Sol455/mic_patch_v1/README.md

#Prototype Wearable Microphone patch for cardiac auscultation

#Parts and Footprint Libraries

Parts located in mic_patch_parts.kicad_sym
Footprints located in parts >  mic_patch_parts.pretty
3D models located in parts  > mic_patch_models.3dspahes
