Sol455/mic_patch_v1/MCU.kicad_sch

## KiCad design MCU.kicad_sch (2025-06-24)

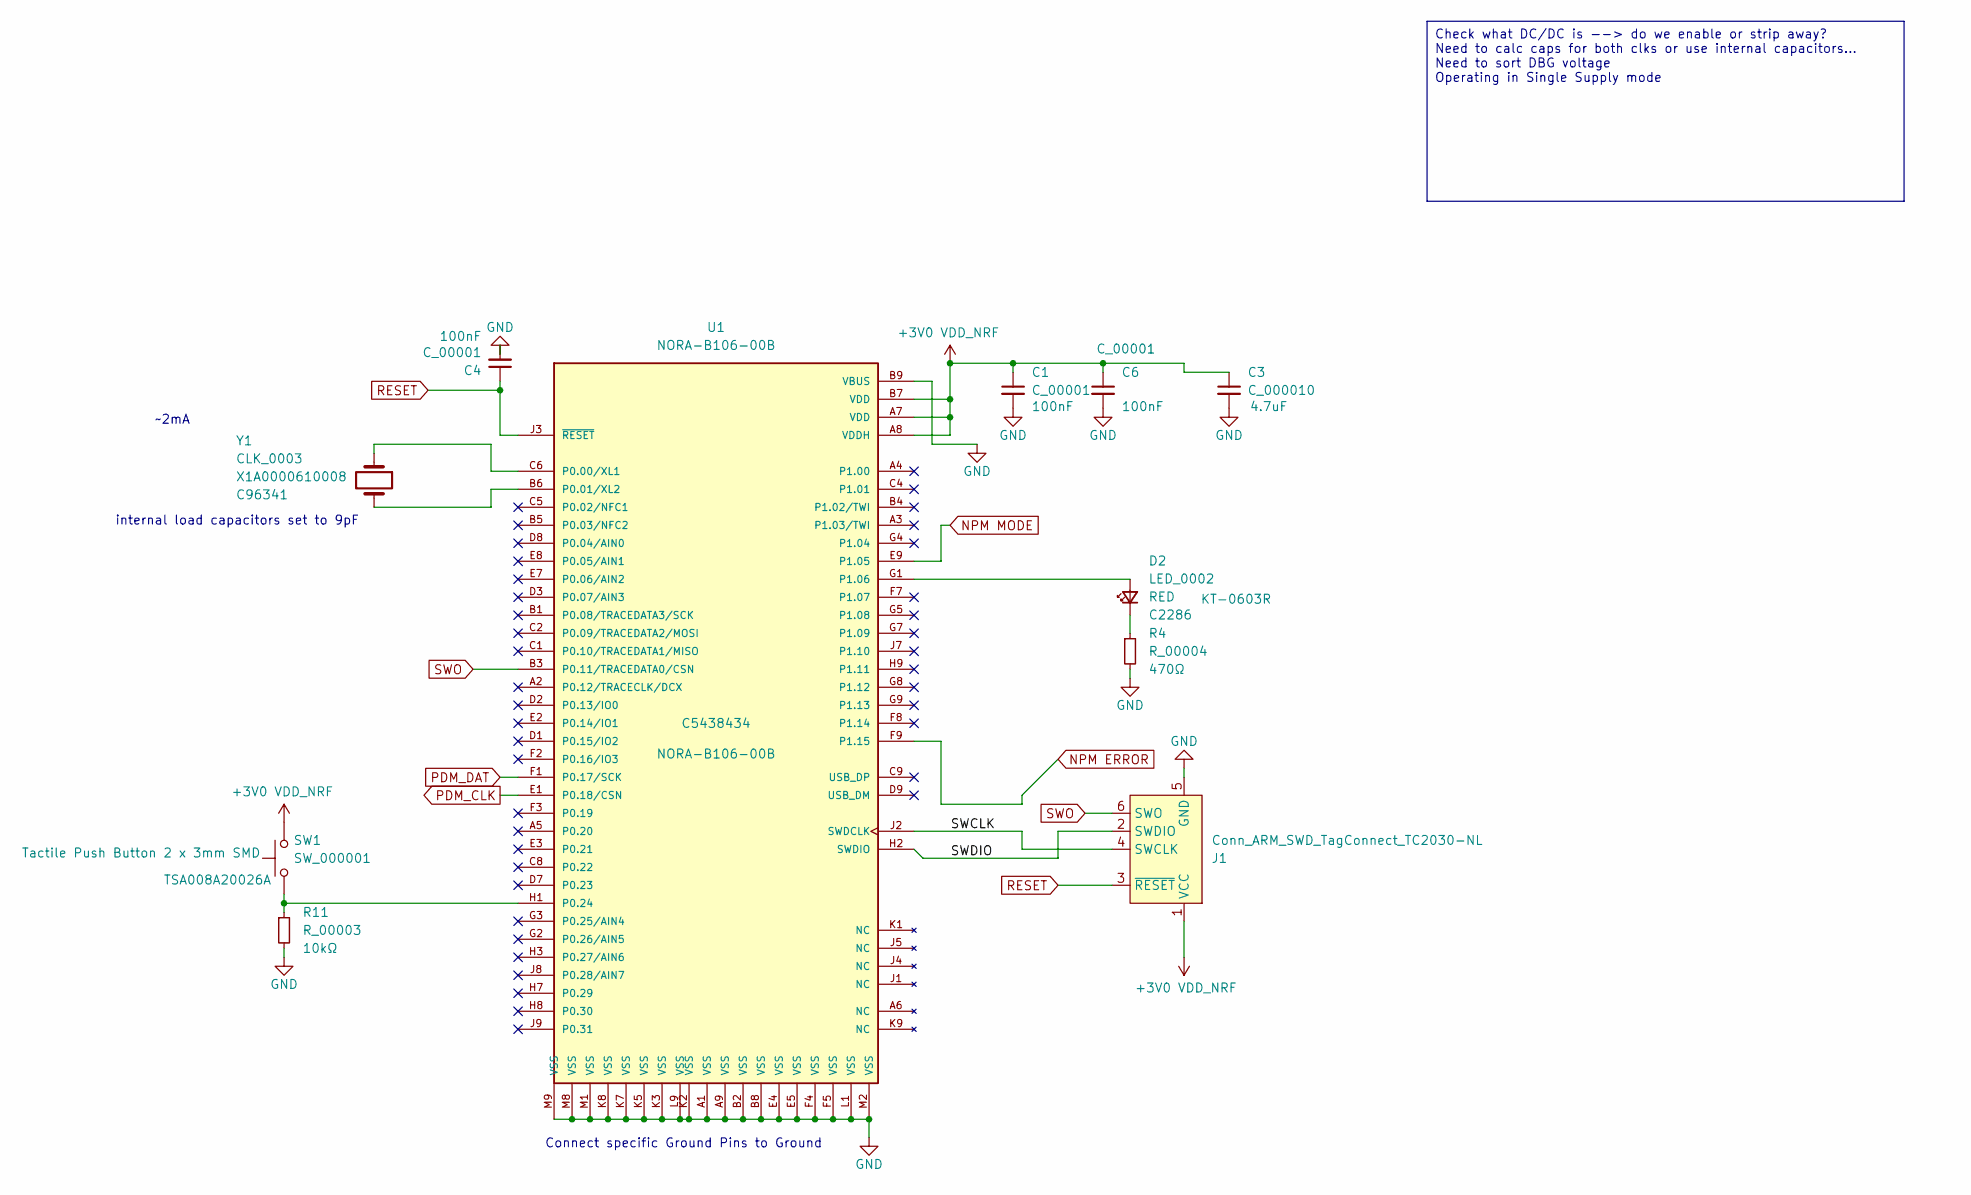
[picture p1: schematic MCU.kicad_sch]

Parts:
C1, C4, C6: C_00001; C_0402_1005Metric; MPNs 0402WGF1002TCE; LCSC PNs C25744
C3: C_000010; C_0402_1005Metric; MPNs CL05A475MP5NRNC; LCSC PNs C23733
D2: LED_0002; LED_0603_1608Metric; LCSC PNs C2286
J1: Conn_ARM_SWD_TagConnect_TC2030-NL; Tag-Connect_TC2030-IDC-NL_2x03_P1.27mm_Vertical
R4: R_00004; R_0402_1005Metric; MPNs 0402WGF4700TCE; LCSC PNs C25117
R11: R_00003; R_0402_1005Metric; MPNs 0402WGF1002TCE; LCSC PNs C25744
SW1: SW_000001; MPNs TSA008A20026A; LCSC PNs C2888880
U1: NORA-B106-00B; PARTREV R05; LCSC PNs C5438434
Y1: CLK_0003; Crystal_SMD_2012-2Pin_2.0x1.2mm; LCSC PNs C96341

Connections:
+3V0 VDD_NRF: C1.1, C3.1, C6.1, J1.1 (VCC), SW1.2, U1.A7 (VDD), U1.A8 (VDDH), U1.B7 (VDD)
GND: C1.2, C3.2, C4.2, C6.2, J1.5 (GND), R4.2, R11.2, U1.A1 (VSS), U1.A9 (VSS), U1.B2 (VSS), U1.B8 (VSS), U1.B9 (VBUS), U1.E4 (VSS), U1.E5 (VSS), U1.F4 (VSS), U1.F5 (VSS), U1.K2 (VSS), U1.K3 (VSS), U1.K5 (VSS), U1.K7 (VSS), U1.K8 (VSS), U1.L1 (VSS), U1.L9 (VSS), U1.M1 (VSS), U1.M2 (VSS), U1.M8 (VSS), U1.M9 (VSS)
NPM ERROR: U1.F9 (P1.15)
NPM MODE: U1.E9 (P1.05)
unnamed: D2.1 (K), R4.1
unnamed: D2.2 (A), U1.G1 (P1.06)
unnamed: R11.1, SW1.1, U1.H1 (P0.24)
unnamed: U1.B6 (P0.01/XL2), Y1.2
unnamed: U1.C6 (P0.00/XL1), Y1.1
PDM_CLK: U1.E1 (P0.18/CSN)
PDM_DAT: U1.F1 (P0.17/SCK)
RESET: C4.1, J1.3 (~RESET), U1.J3 (~RESET)
SWCLK: J1.4 (SWCLK), U1.J2 (SWDCLK)
SWDIO: J1.2 (SWDIO), U1.H2 (SWDIO)
SWO: J1.6 (SWO), U1.B3 (P0.11/TRACEDATA0/CSN)

Notes on the sheet:
Check what DC/DC is --> do we enable or strip away? Need to calc caps for both clks or use internal capacitors... Need to sort DBG voltage Operating in Single Supply mode
internal load capacitors set to 9pF
~2mA
Connect specific Ground Pins to Ground
