Sol455/mic_patch_v1/mic.kicad_sch

## KiCad design mic.kicad_sch (2025-06-24)

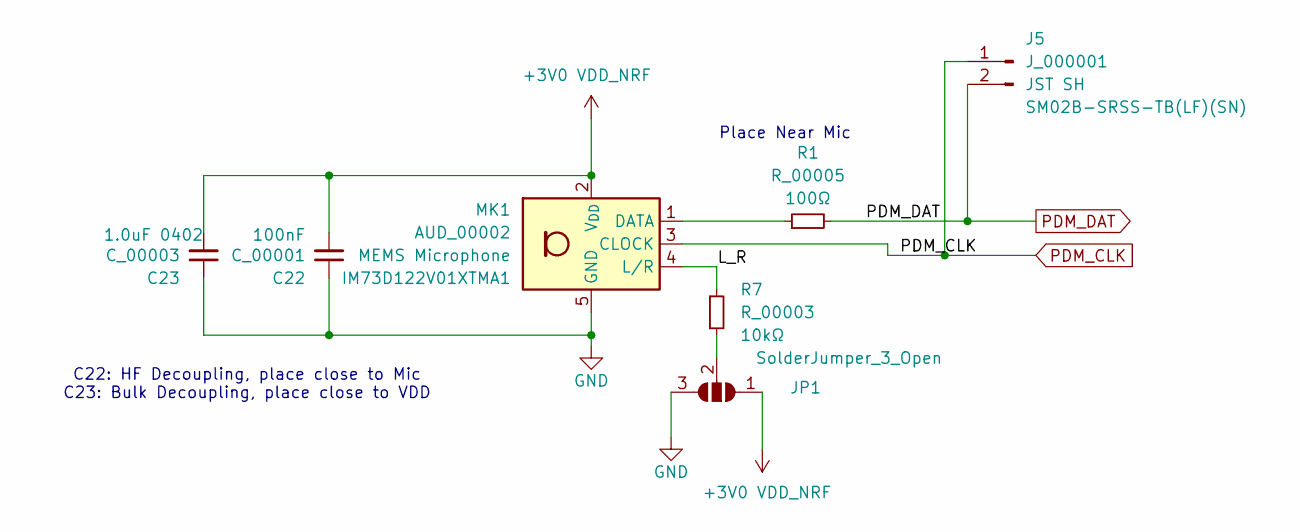
[picture p2: schematic mic.kicad_sch]

Parts:
C22: C_00001; C_0402_1005Metric; MPNs 0402WGF1002TCE; LCSC PNs C25744
C23: C_00003; C_0402_1005Metric; MPNs CL05A105KA5NQNC; LCSC PNs C52923
J5: J_000001; MPNs SM02B-SRSS-TB(LF)(SN); LCSC PNs C160402
JP1: SolderJumper_3_Open; SolderJumper-3_P1.3mm_Open_Pad1.0x1.5mm_NumberLabels
MK1: AUD_00002; MPNs IM73D122V01XTMA1; LCSC PNs C5563886
R1: R_00005; R_0402_1005Metric; MPNs 0402WGF1000TCE; LCSC PNs C25076
R7: R_00003; R_0402_1005Metric; MPNs 0402WGF1002TCE; LCSC PNs C25744

Connections:
+3V0 VDD_NRF: C22.2, C23.2, JP1.1 (A), MK1.2 (V_{DD})
GND: C22.1, C23.1, JP1.3 (B), MK1.5 (GND)
L_R: MK1.4 (L/R), R7.1
unnamed: JP1.2 (C), R7.2
unnamed: MK1.1 (DATA), R1.1
PDM_CLK: J5.1, MK1.3 (CLOCK)
PDM_DAT: J5.2, R1.2

Notes on the sheet:
Place Near Mic
C22: HF Decoupling, place close to Mic C23: Bulk Decoupling, place close to VDD
