Sol455/mic_patch_v1/sd_card.kicad_sch

## KiCad design sd_card.kicad_sch (2025-06-19)

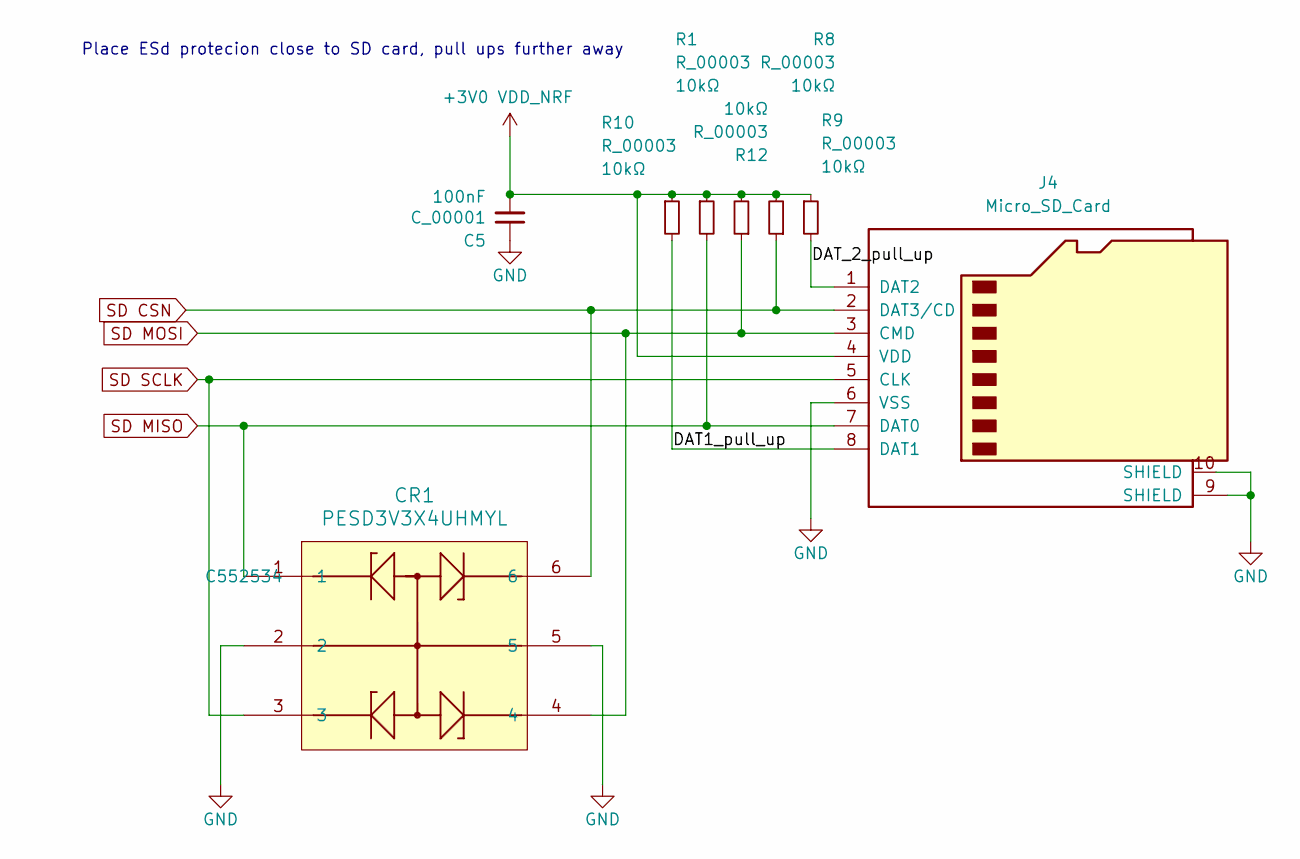
[picture p3: schematic sd_card.kicad_sch]

Parts:
C5: C_00001; C_0402_1005Metric; MPNs 0402WGF1002TCE; LCSC PNs C25744
CR1: PESD3V3X4UHMYL; SOT8006_C552534; LCSC PNs C552534
J4: Micro_SD_Card; TF-SMD_TF-017; LCSC PNs C410348
R1, R8, R9, R10, R12: R_00003; R_0402_1005Metric; MPNs 0402WGF1002TCE; LCSC PNs C25744

Connections:
+3V0 VDD_NRF: C5.2, J4.4 (VDD), R1.1, R8.2, R9.1, R10.1, R12.2
DAT1_pull_up: J4.8 (DAT1), R10.2
DAT_2_pull_up: J4.1 (DAT2), R9.2
GND: C5.1, CR1.2, CR1.5, J4.6 (VSS), J4.9 (SHIELD), J4.10 (SHIELD)
SD CSN: CR1.6, J4.2 (DAT3/CD), R8.1
SD MISO: CR1.1, J4.7 (DAT0), R1.2
SD MOSI: CR1.4, J4.3 (CMD), R12.1
SD SCLK: CR1.3, J4.5 (CLK)

Notes on the sheet:
Place ESd protecion close to SD card, pull ups further away
