Sol455/mic_patch_v1/untitled.kicad_sch

## KiCad design untitled.kicad_sch (2025-06-24)

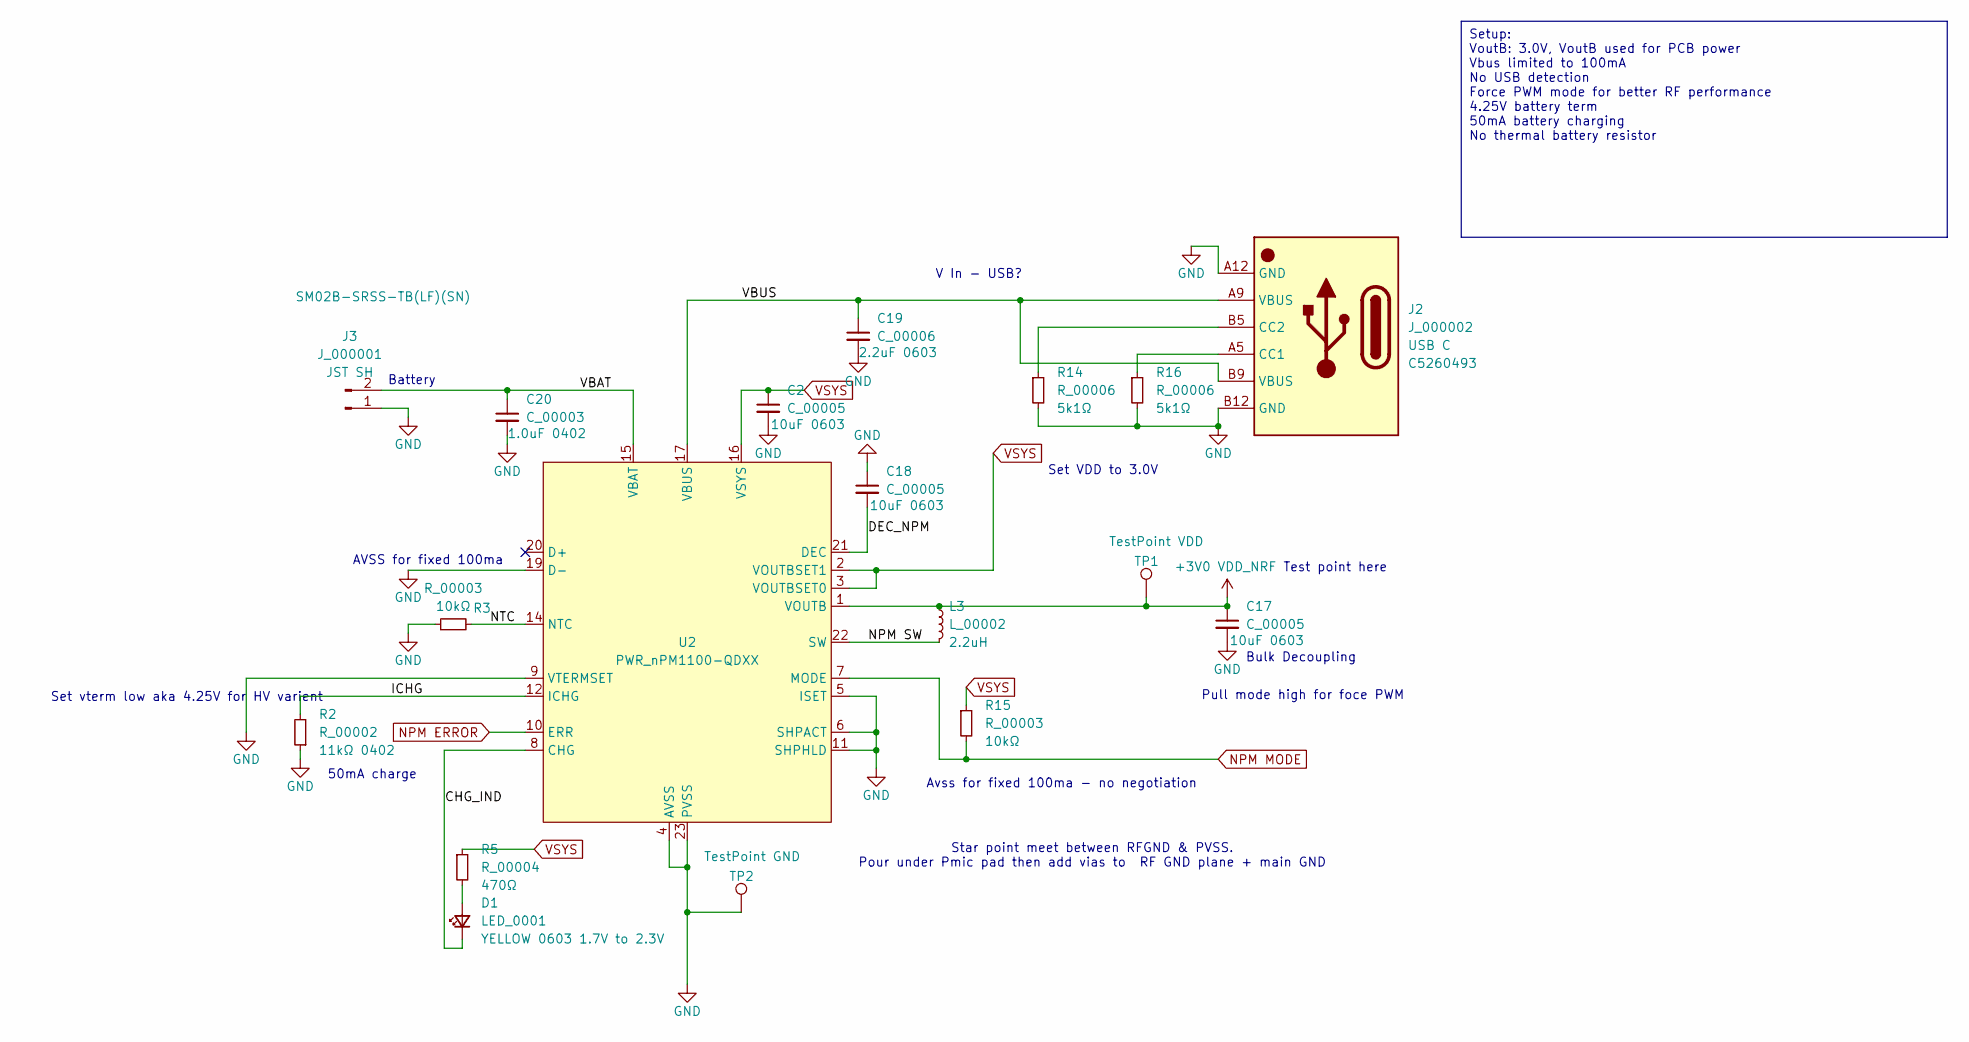
[picture p4: schematic untitled.kicad_sch]

Parts:
C2, C17, C18: C_00005; C_0603_1608Metric; MPNs CL10A106KP8NNNC; LCSC PNs C19702
C19: C_00006; C_0603_1608Metric; MPNs CL10A225KO8NNNC; LCSC PNs C23630
C20: C_00003; C_0402_1005Metric; MPNs CL05A105KA5NQNC; LCSC PNs C52923
D1: LED_0001; LED_0603_1608Metric; MPNs 19-213/Y2C-CQ2R2L/3T(CY); LCSC PNs C72038
J2: J_000002; LCSC PNs C5260493
J3: J_000001; MPNs SM02B-SRSS-TB(LF)(SN); LCSC PNs C160402
L3: L_00002; L_0805_2012Metric; LCSC PNs C1043
R2: R_00002; R_0402_1005Metric; MPNs 0402WGF1102TCE; LCSC PNs C25749
R3, R15: R_00003; R_0402_1005Metric; MPNs 0402WGF1002TCE; LCSC PNs C25744
R5: R_00004; R_0402_1005Metric; MPNs 0402WGF4700TCE; LCSC PNs C25117
R14, R16: R_00006; R_0402_1005Metric; MPNs 0402WGF5101TCE; LCSC PNs C25905
TP1: TestPoint VDD; TestPoint_Pad_D1.5mm
TP2: TestPoint GND; TestPoint_Pad_D1.5mm
U2: PWR_nPM1100-QDXX; QFN-24-1EP_4x4mm_P0.5mm_EP2.6x2.6mm_ThermalVias; LCSC PNs C7249860

Connections:
+3V0 VDD_NRF: C17.1, L3.1, TP1.1, U2.1 (VOUTB)
CHG_IND: D1.1 (K), U2.8 (CHG)
DEC_NPM: C18.2, U2.21 (DEC)
GND: C2.2, C17.2, C18.1, C19.2, C20.2, J2.A12 (GND), J2.B12 (GND), J3.1, R2.1, R3.1, R14.2, R16.2, TP2.1, U2.4 (AVSS), U2.5 (ISET), U2.6 (SHPACT), U2.9 (VTERMSET), U2.11 (SHPHLD), U2.19 (D-), U2.23 (PVSS), U2.25 (AVSS)
ICHG: R2.2, U2.12 (ICHG)
NPM ERROR: U2.10 (ERR)
NPM MODE: R15.2, U2.7 (MODE)
NPM SW: L3.2, U2.22 (SW)
NTC: R3.2, U2.14 (NTC)
unnamed: D1.2 (A), R5.2
unnamed: J2.A5 (CC1), R16.1
unnamed: J2.B5 (CC2), R14.1
VBAT: C20.1, J3.2, U2.15 (VBAT)
VBUS: C19.1, J2.A9 (VBUS), J2.B9 (VBUS), U2.17 (VBUS)
VSYS: C2.1, R5.1, R15.1, U2.2 (VOUTBSET1), U2.3 (VOUTBSET0), U2.16 (VSYS)

Notes on the sheet:
Setup: VoutB: 3.0V, VoutB used for PCB power Vbus limited to 100mA No USB detection Force PWM mode for better RF performance 4.25V battery term 50mA battery charging No thermal battery resistor
Star point meet between RFGND & PVSS. Pour under Pmic pad then add vias to RF GND plane + main GND
Pull mode high for foce PWM
Set VDD to 3.0V
V In - USB?
AVSS for fixed 100ma
Avss for fixed 100ma - no negotiation
Bulk Decoupling
Battery
Test point here
Set vterm low aka 4.25V for HV varient
50mA charge
