Sol455/mic_patch_v1/(commit log)

2025-02-10 Added MCU schematic, added power decoupling, Debug + HFCLK oscillator
    [MCU.kicad_sch, RF.kicad_sch, mic.kicad_sch, mic_patch_v1.kicad_sch, untitled.kicad_sch]
2025-02-10 added inductors for DCDC regulators
    [MCU.kicad_sch]
2025-02-14 routed power
    [MCU.kicad_sch, untitled.kicad_sch]
2025-02-14 added in LFCLK
    [MCU.kicad_sch, untitled.kicad_sch]
2025-02-15 added ADAU7002 Symbol
    [MCU.kicad_sch, mic.kicad_sch, untitled.kicad_sch]
2025-02-15 added MEMS microphone symbol
    [MCU.kicad_sch, mic.kicad_sch]
2025-02-15 added rudimentary RF matching network
    [MCU.kicad_sch, RF.kicad_sch, mic.kicad_sch, untitled.kicad_sch]
2025-02-22 tided up
    [RF.kicad_sch]
2025-02-22 added NORA-B106 module, routed SWD/SWO, + power + audio
    [MCU.kicad_sch]
2025-02-22 removed RF schematic
    [RF.kicad_sch]
2025-02-22 updated power supply to 3.0V to support micro SD card
    [MCU.kicad_sch, mic.kicad_sch, mic_patch_v1.kicad_sch, untitled.kicad_sch]
2025-02-22 routed pins for SD card
    [MCU.kicad_sch, mic.kicad_sch, mic_patch_v1.kicad_sch, sd_card.kicad_sch, untitled.kicad_sch]
2025-02-23 Added pull ups to SD data lines in line with SD standard
    [MCU.kicad_sch, sd_card.kicad_sch]
2025-02-23 Added SD card ESD protection
    [sd_card.kicad_sch]
2025-02-23 added decoupling to micro SD card
    [sd_card.kicad_sch]
2025-02-23 added two active high push buttons
    [MCU.kicad_sch, untitled.kicad_sch]
2025-02-23 changed vterm to 4.25V on the npm1100, added GPIO control of npm1100 BUCK modes
    [MCU.kicad_sch, sd_card.kicad_sch, untitled.kicad_sch]
2025-02-23 added symbol, 3D model and footprint for nora ble module
    [MCU.kicad_sch]
2025-02-25 added schmatic symbols and footprints for key capacitors, selected LCXO crystal to use internal caps
    [MCU.kicad_sch, mic.kicad_sch, mic_patch_v1.kicad_pcb, sd_card.kicad_sch, untitled.kicad_sch]
2025-02-26 added SMD indicator LED symbol & footprint
    [MCU.kicad_sch, mic_patch_v1.kicad_pcb, untitled.kicad_sch]
2025-02-26 added JST connector symbol + footprint
    [MCU.kicad_sch, mic_patch_v1.kicad_pcb, untitled.kicad_sch]
2025-02-26 added all footprints for power module
    [mic.kicad_sch, mic_patch_v1.kicad_pcb, untitled.kicad_sch]
2025-02-26 Added USB symbol + 5.1k pull downs
    [mic_patch_v1.kicad_pcb, untitled.kicad_sch]
2025-02-27 added footprints for every part
    [mic.kicad_sch, mic_patch_v1.kicad_pcb, sd_card.kicad_sch, untitled.kicad_sch]
2025-02-27 assigned net classes for Power, Audio, SWD, SD
    [MCU.kicad_sch, mic.kicad_sch, sd_card.kicad_sch, untitled.kicad_sch]
2025-02-27 fixed SD card footprintg
    [MCU.kicad_sch, mic_patch_v1.kicad_pcb]
2025-02-27 sketched out power
    [mic_patch_v1.kicad_pcb]
2025-02-27 laid out sub modules
    [mic_patch_v1.kicad_pcb]
2025-02-27 routed Option 1
    [mic_patch_v1.kicad_pcb]
2025-02-27 routed design option 2
    [mic_patch_v1.kicad_pcb]
2025-03-06 Revert "routed design option 2"
    This reverts commit caba051f962482bea6f5010ae69f259f1d32f7a5.
    [mic_patch_v1.kicad_pcb]
2025-03-06 added test points
    [MCU.kicad_sch, mic.kicad_sch, mic_patch_v1.kicad_pcb, untitled.kicad_sch]
2025-03-06 added additional decoupling capacitors
    [MCU.kicad_sch]
2025-03-06 fixed ERC errors
    [MCU.kicad_sch, sd_card.kicad_sch, untitled.kicad_sch]
2025-03-06 added board stack, up and constraints
    [mic_patch_v1.kicad_pcb]
2025-03-06 sketched out board dimensions
    [mic_patch_v1.kicad_pcb]
2025-03-10 poured ground layer added RF keep out
    [mic.kicad_sch, mic_patch_v1.kicad_pcb, untitled.kicad_sch]
2025-03-10 added RF ground plane stitching vias
    [mic_patch_v1.kicad_pcb]
2025-03-10 switched around pins for easier routing
    [MCU.kicad_sch, mic_patch_v1.kicad_pcb]
2025-03-10 routed audio
    [mic.kicad_sch, mic_patch_v1.kicad_pcb]
2025-03-11 routed SWD/SWO
    [mic_patch_v1.kicad_pcb]
2025-03-11 swapped MOSI and MISO pins on SD ESD
    [mic_patch_v1.kicad_pcb, sd_card.kicad_sch]
2025-03-11 first SD route
    [mic_patch_v1.kicad_pcb]
2025-03-11 routed SD 2
    [mic_patch_v1.kicad_pcb]
2025-03-11 re routed audio
    [mic_patch_v1.kicad_pcb]
2025-03-12 routed most of power
    [mic_patch_v1.kicad_pcb]
2025-03-13 re-routed buttons to closer pins
    [MCU.kicad_sch, mic_patch_v1.kicad_pcb, untitled.kicad_sch]
2025-03-13 routed every component, added GPIO breakouts
    [MCU.kicad_sch, mic_patch_v1.kicad_pcb]
2025-03-13 star routed power
    [mic_patch_v1.kicad_pcb]
2025-03-13 adjusted power supply
    [mic_patch_v1.kicad_pcb]
2025-03-13 added ground pour for PVSS on NPM1100
    [mic_patch_v1.kicad_pcb]
2025-03-13 poured additional ground planes
    [mic_patch_v1.kicad_pcb]
2025-03-17 fixed all major DRC warnings and errors
    [mic_patch_v1.kicad_pcb, sd_card.kicad_sch]
2025-03-17 added silkscreen
    [mic_patch_v1.kicad_pcb]
2025-03-17 removed PDM series termination resistor under guidance from MS-2472 analogue devices
    [mic.kicad_sch, mic_patch_v1.kicad_pcb]
2025-03-17 final tweaks
    [mic_patch_v1.kicad_pcb]
2025-03-17 corrected missing part numbers + inconsistencies
    [MCU.kicad_sch, mic.kicad_sch, mic_patch_v1.kicad_pcb, sd_card.kicad_sch, untitled.kicad_sch]
2025-03-17 updated ESD footprint
    [mic_patch_v1.kicad_pcb, sd_card.kicad_sch]
2025-03-17 tidied up silkscreen
    [mic_patch_v1.kicad_pcb]
2025-03-17 Order MK1.0
    [mic_patch_v1.kicad_pcb]
2025-03-17 slight rejig of star power
    [mic_patch_v1.kicad_pcb]
2025-03-17 moved via to outside keep out zone
    [mic_patch_v1.kicad_pcb]
2025-03-25 updated footprint for C19, corrected
    [mic_patch_v1.kicad_pcb, untitled.kicad_sch]
2025-03-25 removed unnecessary layers on SD, USB and EMC footprints to reduce fab output issues
    [mic_patch_v1.kicad_pcb]
2025-03-25 added solder jumper to configure mic
    [mic.kicad_sch, mic_patch_v1.kicad_pcb]
2025-03-25 updatded jumper
    [mic_patch_v1.kicad_pcb]
2025-06-19 Removed 1 push button
    [MCU.kicad_sch]
2025-06-19 Removed ADAU7002, + test points
    [MCU.kicad_sch, mic.kicad_sch]
2025-06-22 Removed SD Card from schematic
    [MCU.kicad_sch, mic.kicad_sch, mic_patch_v1.kicad_pcb, mic_patch_v1.kicad_sch, untitled.kicad_sch]
2025-06-23 tested different shapes
    [mic_patch_v1.kicad_pcb]
2025-06-24 Re routed power, placed Nora b106 module
    [mic.kicad_sch, mic_patch_v1.kicad_pcb]
2025-06-24 Re routed Mems microphone, added 100ohm termination resistor on PDM_DAT, changed pins
    [MCU.kicad_sch, mic.kicad_sch, mic_patch_v1.kicad_pcb]
2025-06-24 updated button and LED pins
    [MCU.kicad_sch]
2025-06-24 Routed button and LED
    [MCU.kicad_sch, mic_patch_v1.kicad_pcb]
2025-06-24 Poured Ground Planes
    [mic_patch_v1.kicad_pcb]
